PonderSlime/Keyboards/README.md

# Keyboards

A collection of all my personal keyboard projects.
