PonderSlime/Keyboards/keyboards/ergo-kola/README.md

# Ergo-Kola

Planck-inspired ergonomic split keyboard.
Origonally I was going to design a different split keyboard (which i completed), since I thought it would be really cool to have. However, after letting it sit for over a week, I decided that I was not yet statisfied with the final product. Some of these reasons are listed here:
- non-symetric layout
- Neopixels wired incorrectly
- Insane ammout of keys
- Not erginomic or intuitive

By keeping these in mind for my second revision, I was able to complete something that I am much more satisfied with! 

## Bill of Material (without neopixels)
| Part | Qty | Price | Link |
| --- | --- | --- | --- |
| Raspberry Pi Pico | 2 | $10.00 | https://www.digikey.com/en/products/detail/raspberry-pi/SC1631/24627136 |
| PJ-320A TRRS Jack | 2 | $1.00 | https://keeb.io/products/trrs-jack-3-5mm |
| 40cm TRRS Coiled Angled Cable | 1 | $3.99 | https://keeb.io/products/trrs-cable?variant=50550149190 |
| 10uf 0805 Capacitor | 18 | $1.50 | https://www.digikey.com/en/products/detail/murata-electronics/GRM21BR61C106KE15K/2546903 |
| 1N4148W SOD-123 SMD Diode | 52 | $3.85 | https://www.digikey.com/en/products/detail/smc-diode-solutions/1N4148W/6022450 |
| Kailh MX Hotswap Sockets | 52 | $6.60 | https://mechanicalkeyboards.com/products/kailh-switch-hot-swap-socket |
| MX Switches (LED Compatible) | 52 | $20.80 | https://mechanicalkeyboards.com/products/cherry-mx2a-blue-60g-clicky?variant=48020492091692 |
| PCB | 2 | $102.00 | --- | 
| Microcontrollers | 2 | $10.00 | --- |
| Misc Electronics | --- | $12.95 | --- |
| Fasteners | 1 | $3.99 | --- |
| Keys | 52 | $20.80 | --- |
| Keycaps | 52 | $22.00 | --- |
| Shipping | --- | $40.00 | --- |
| Total Price Without Tariffs or shipping | --- | $144.74 | --- |
| Total Price With Tariffs and shipping, since 'merica :c | --- | $211.74 | --- |

## Onshape Link
[https://cad.onshape.com/documents/dbf06a8110e493f29468ba71/w/71af0cc0c8fe44a78097d876/e/75953963970660d857342981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](https://cad.onshape.com/documents/dbf06a8110e493f29468ba71/w/71af0cc0c8fe44a78097d876/e/75953963970660d857342981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)

20250317_10h35m05s_grim
20250317_10h34m52s_grim
20250317_10h34m39s_grim
