PonderSlime/Keyboards/keyboards/split-kola/render/render.png

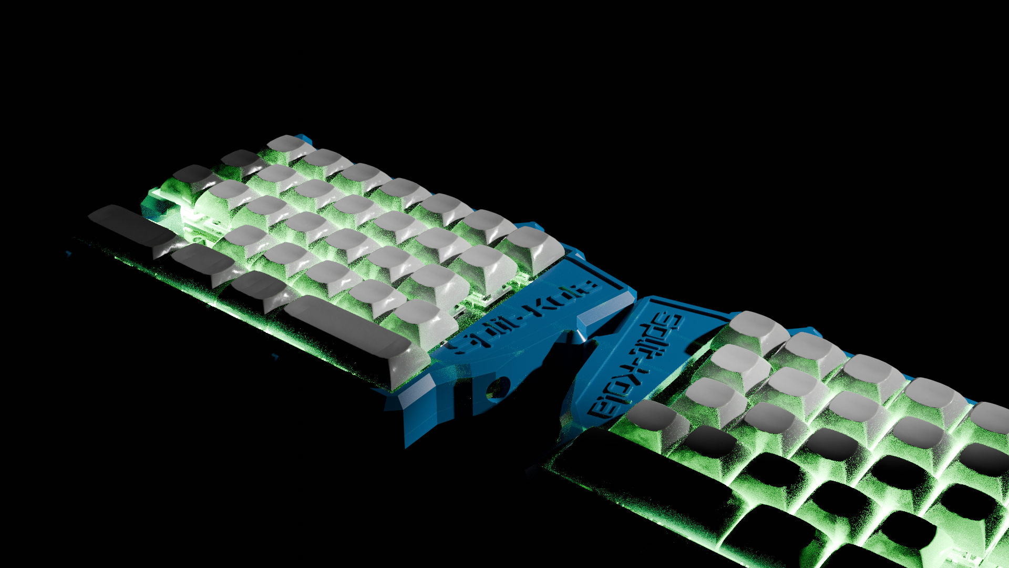
keyboards/split-kola/render/render.png
