PonderSlime/Keyboards/keycaps/QSA/reference/dsa_reference.png

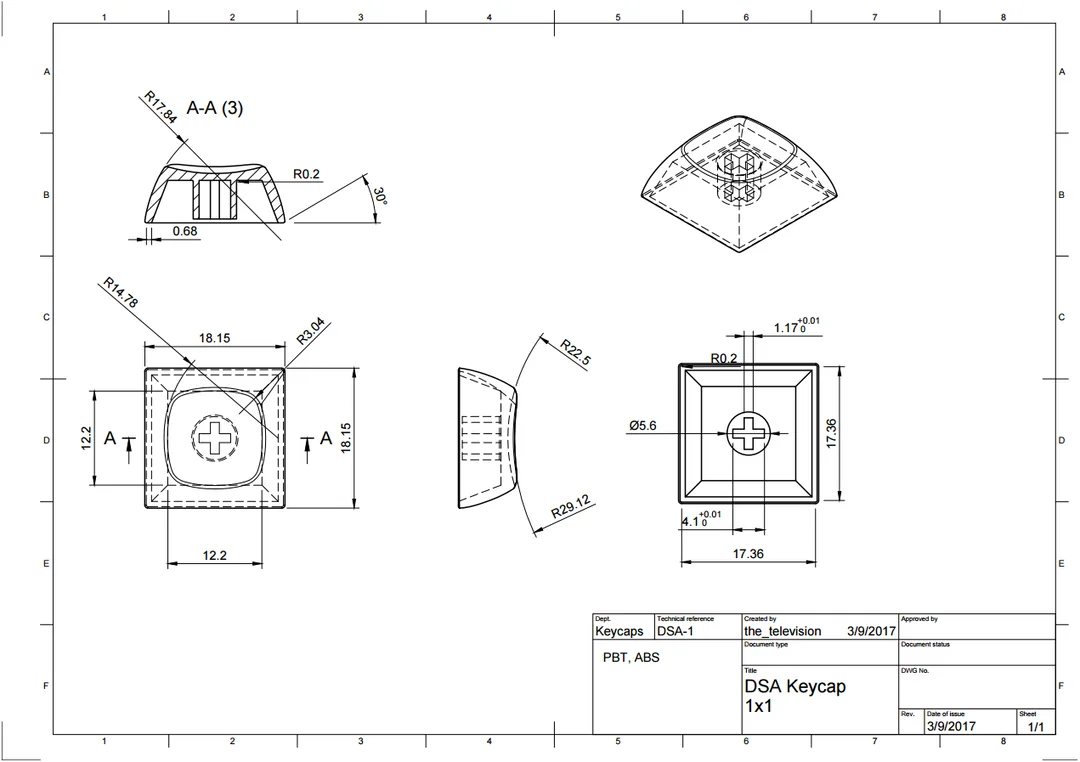
keycaps/QSA/reference/dsa_reference.png
