PonderSlime/Keyboards/keyboards/ergo-kola/cad/export/Ergo-Kola 3D Printed Parts/3D printed parts - Right Case Top.step

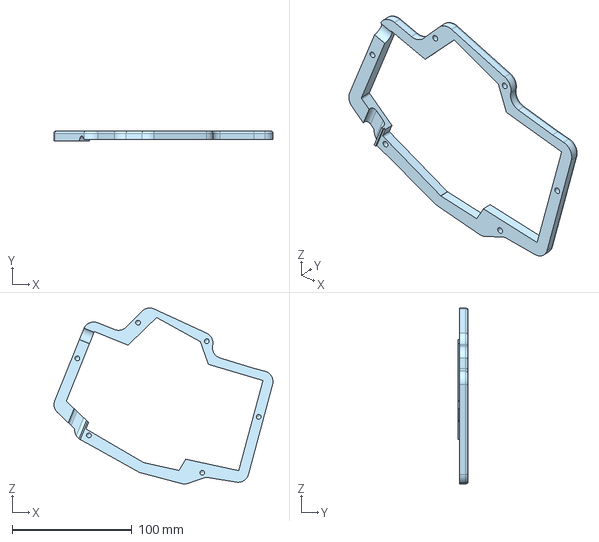
[picture p6: CAD file, 2025-03-15]
keyboards/ergo-kola/cad/export/Ergo-Kola 3D Printed Parts/3D printed parts - Right Case Top.step
183.0 x 8.50 x 147.0 mm
