PonderSlime/Keyboards/keyboards/ergo-kola/cad/reference/plate.dxf

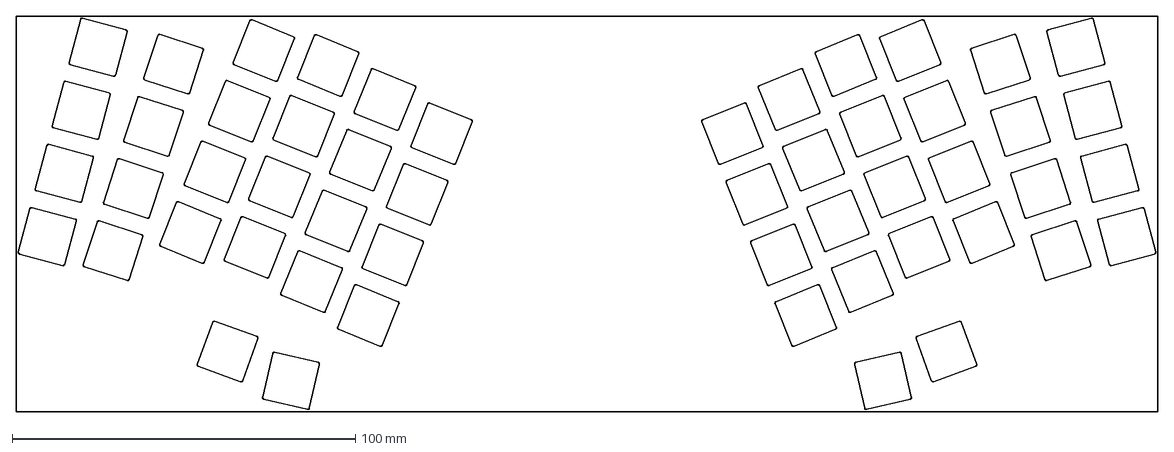
[picture p7: CAD file, 2025-03-15]
keyboards/ergo-kola/cad/reference/plate.dxf
332.6 x 115.3 mm
