PonderSlime/Keyboards/keyboards/ergo-kola/ergogen/output/outlines/right_board_keys_outline.dxf

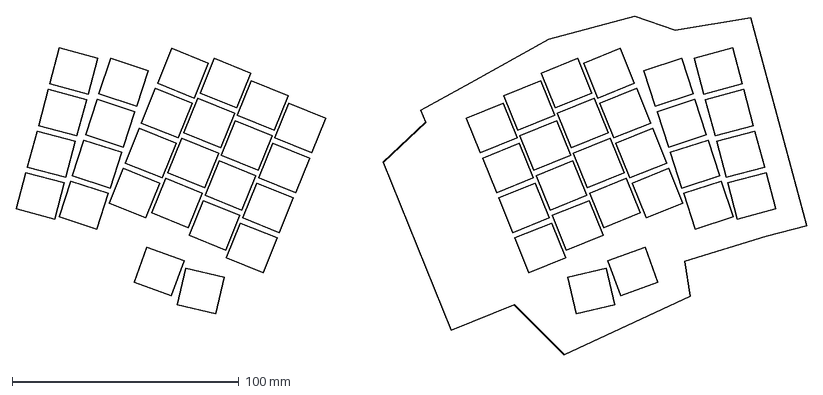
[picture p8: CAD file, 2025-03-15]
keyboards/ergo-kola/ergogen/output/outlines/right_board_keys_outline.dxf
348.5 x 149.2 mm
