PonderSlime/Keyboards/keyboards/split-kola/cad/export/step/3D Printed Parts - Left Plate.step

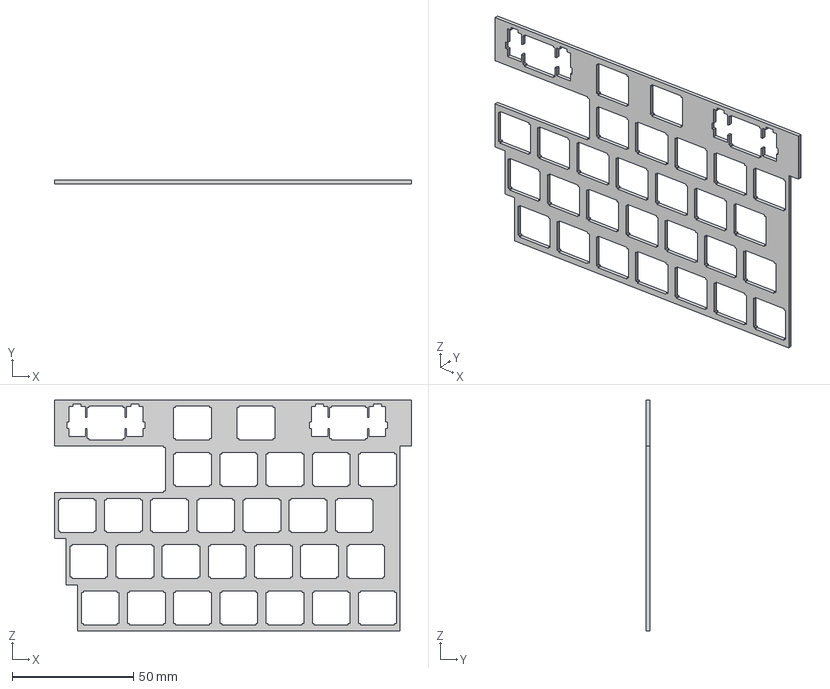
[picture p9: CAD file, 2025-02-25]
keyboards/split-kola/cad/export/step/3D Printed Parts - Left Plate.step
147.2 x 1.50 x 95.3 mm
