PonderSlime/Keyboards/keyboards/split-kola/cad/reference/plate_base.dxf

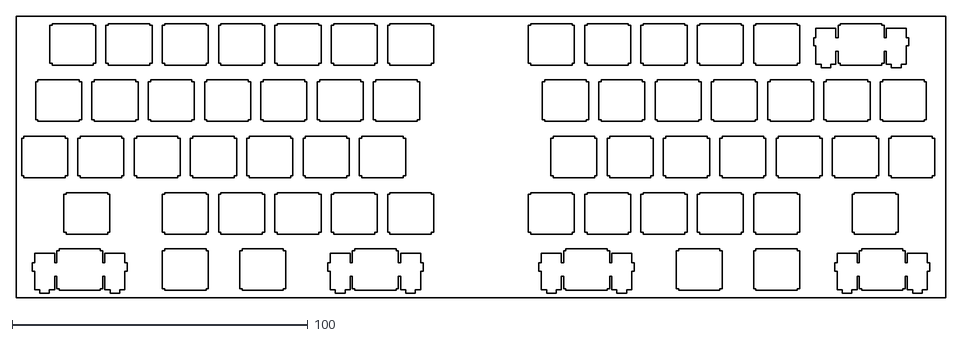
[picture p10: CAD file, 2025-02-24]
keyboards/split-kola/cad/reference/plate_base.dxf
314.3 x 95.2
