PonderSlime/Keyboards/keycaps/QSA/export/QSA V2 - Keycap.step

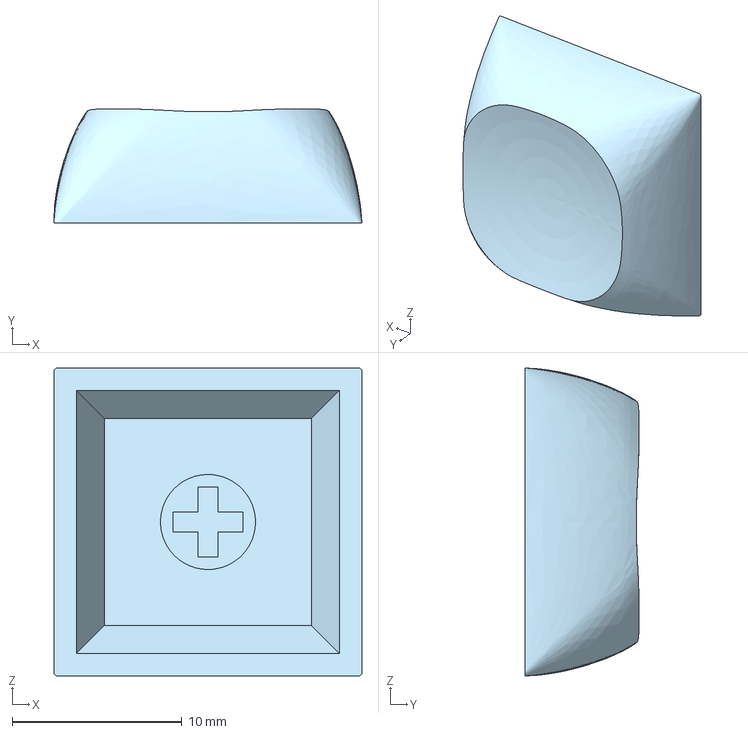
[picture p11: CAD file, 2025-03-17]
keycaps/QSA/export/QSA V2 - Keycap.step
18.1 x 6.74 x 18.1 mm
