PonderSlime/Keyboards/keycaps/QSA/QSA - Keycap x8.3mf

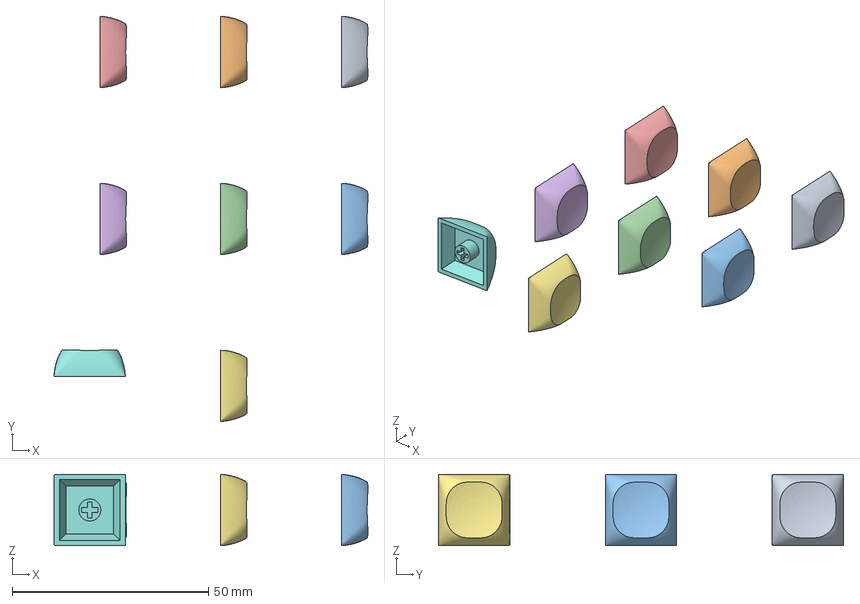
[picture p12: CAD file, 2025-03-17]
keycaps/QSA/QSA - Keycap x8.3mf
79.9 x 103.2 x 18.1 mm
QSA - Keycap.step x 8
