PonderSlime/Keyboards/keyboards/ergo-kola/cad/export/Ergo-Kola 3D Printed Parts/3D printed parts - Right Plate.step

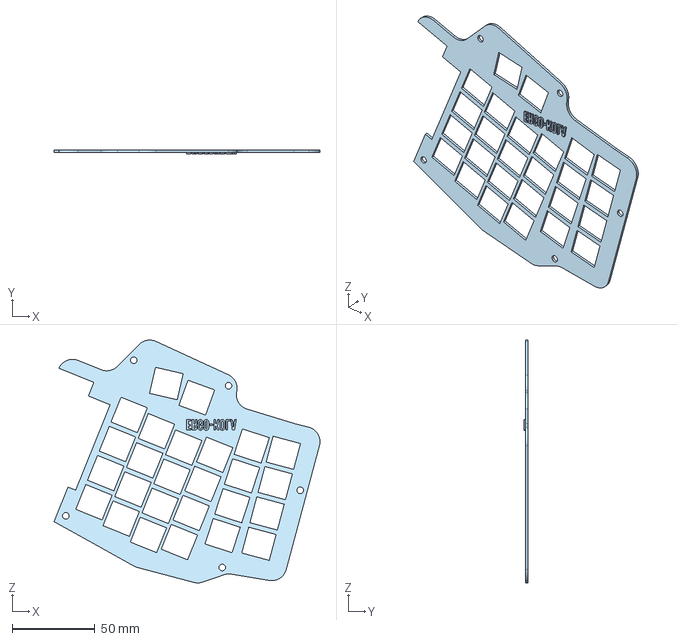
[picture p13: CAD file, 2025-03-15]
keyboards/ergo-kola/cad/export/Ergo-Kola 3D Printed Parts/3D printed parts - Right Plate.step
161.0 x 2.50 x 147.0 mm
