PonderSlime/Keyboards/keyboards/ergo-kola/ergogen/output/outlines/left_board_keys_outline.dxf

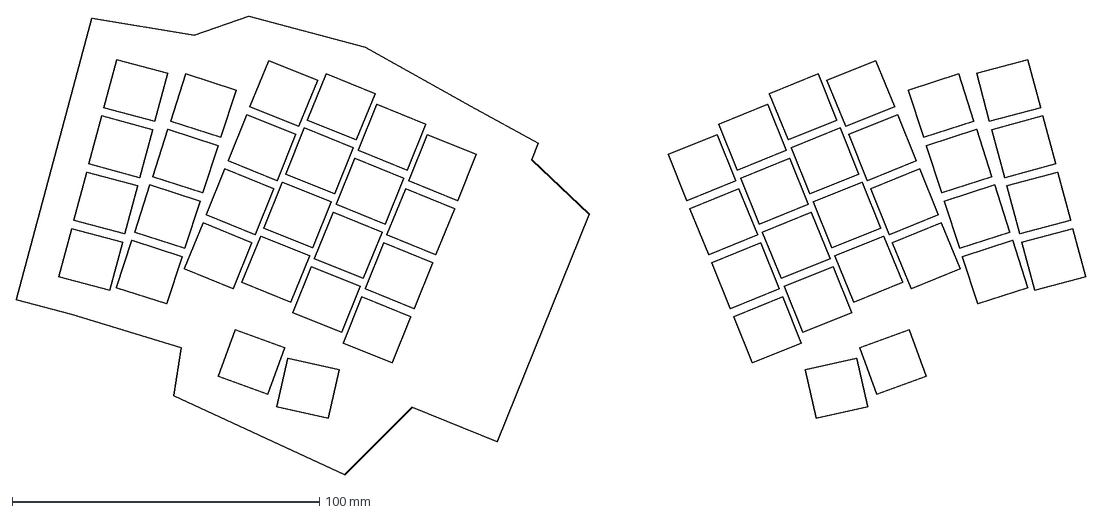
[picture p14: CAD file, 2025-03-15]
keyboards/ergo-kola/ergogen/output/outlines/left_board_keys_outline.dxf
348.4 x 149.2 mm
