PonderSlime/Keyboards/keyboards/split-kola/cad/export/step/3D Printed Parts - Right Top.step

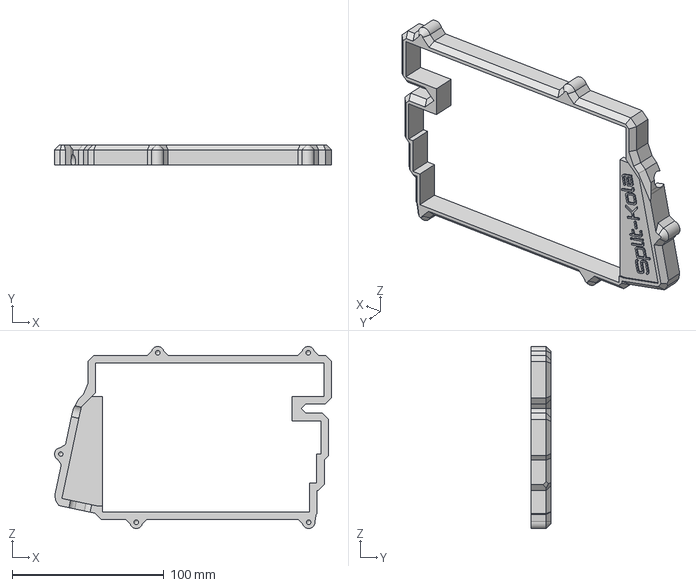
[picture p15: CAD file, 2025-02-25]
keyboards/split-kola/cad/export/step/3D Printed Parts - Right Top.step
182.5 x 12.9 x 120.0 mm
