PonderSlime/Keyboards/keyboards/ergo-kola/cad/export/Ergo-Kola 3D Printed Parts/3D printed parts - Right Case Bottom.step

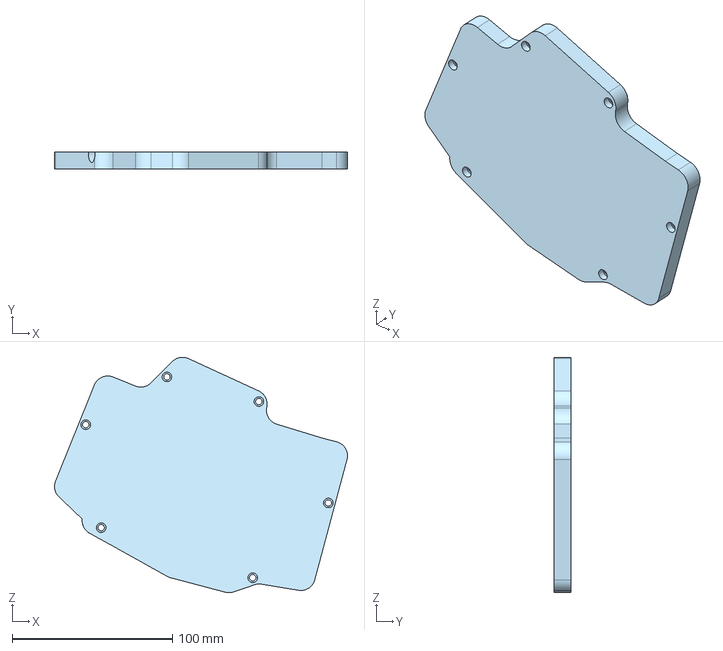
[picture p16: CAD file, 2025-03-15]
keyboards/ergo-kola/cad/export/Ergo-Kola 3D Printed Parts/3D printed parts - Right Case Bottom.step
183.0 x 10.7 x 147.0 mm
