PonderSlime/Keyboards/keyboards/ergo-kola/ergogen/output/outlines/right_board_outline.dxf

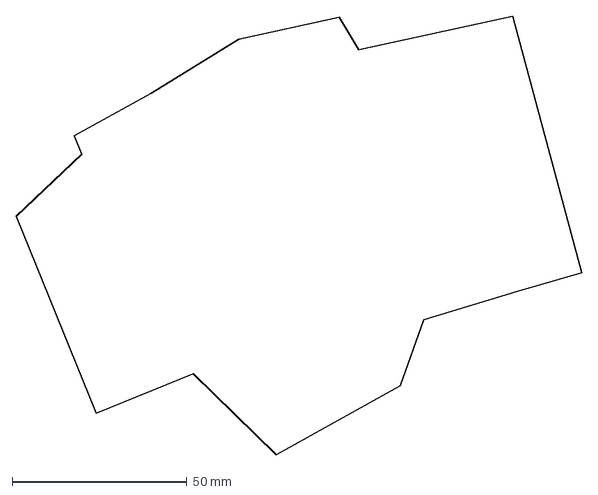
[picture p17: CAD file, 2025-03-15]
keyboards/ergo-kola/ergogen/output/outlines/right_board_outline.dxf
161.7 x 125.4 mm
