PonderSlime/Keyboards/keyboards/ergo-kola/ergogen/output/outlines/keys.dxf

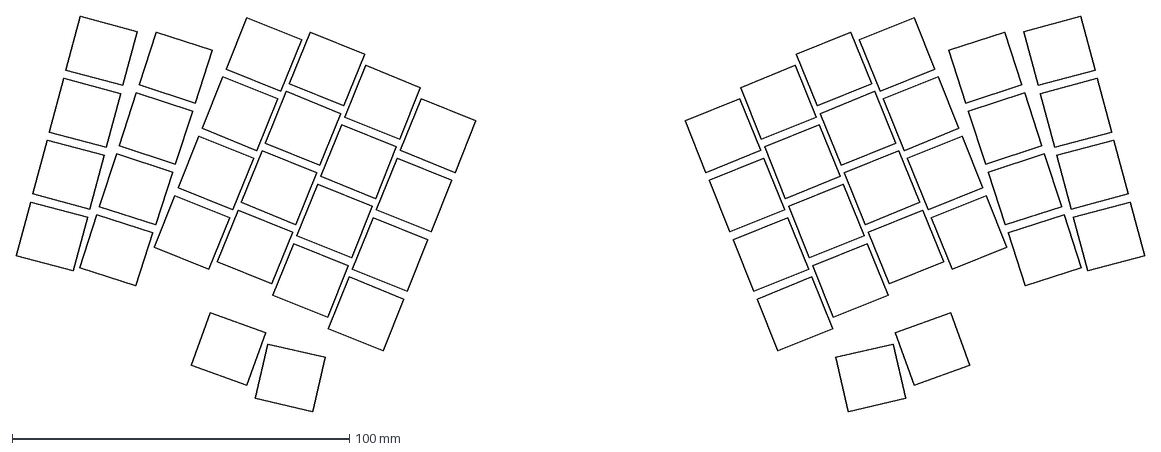
[picture p18: CAD file, 2025-03-15]
keyboards/ergo-kola/ergogen/output/outlines/keys.dxf
334.9 x 117.2 mm
