PonderSlime/Keyboards/keyboards/split-kola/cad/export/step/3D Printed Parts - Right Bottom.step

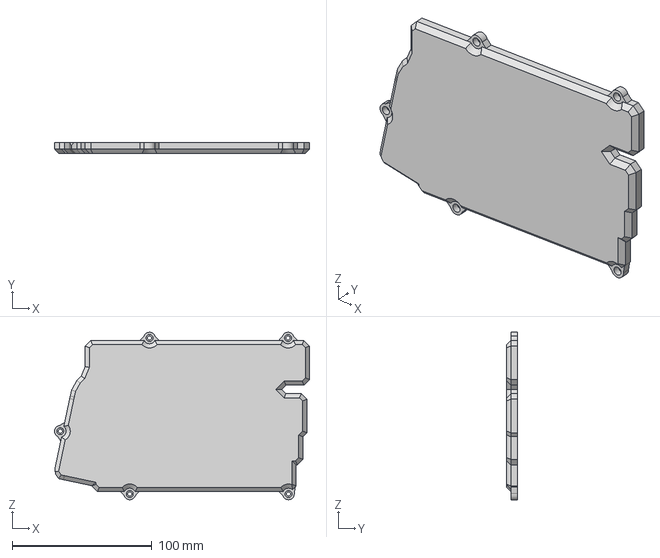
[picture p20: CAD file, 2025-02-25]
keyboards/split-kola/cad/export/step/3D Printed Parts - Right Bottom.step
182.5 x 7.65 x 120.0 mm
