PonderSlime/Keyboards/keyboards/ergo-kola/ergogen/output/outlines/raw.dxf

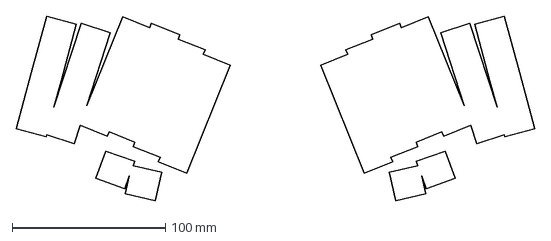
[picture p21: CAD file, 2025-03-15]
keyboards/ergo-kola/ergogen/output/outlines/raw.dxf
337.9 x 120.3 mm
