PonderSlime/Keyboards/keyboards/ergo-kola/ergogen/output/outlines/left_board.dxf

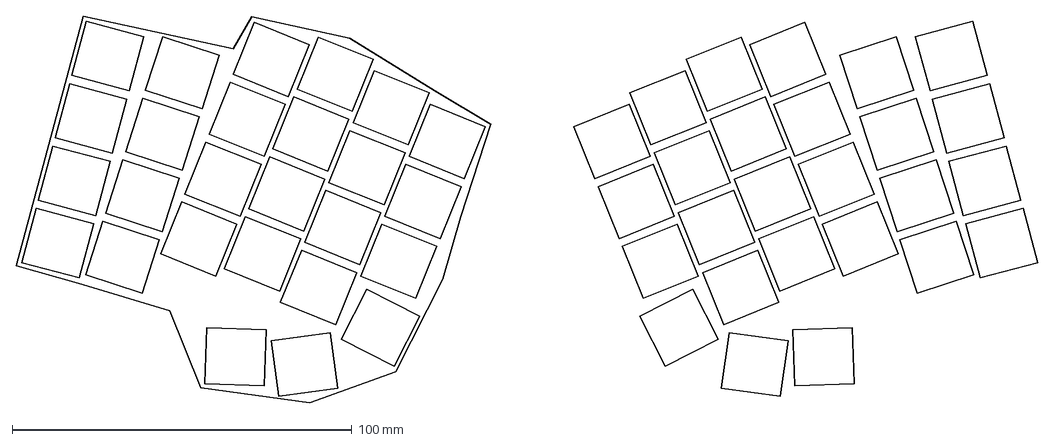
[picture p22: CAD file, 2025-03-13]
keyboards/ergo-kola/ergogen/output/outlines/left_board.dxf
300.4 x 113.8 mm
