PonderSlime/Keyboards/keyboards/ergo-kola/ergogen/output/outlines/right_board.dxf

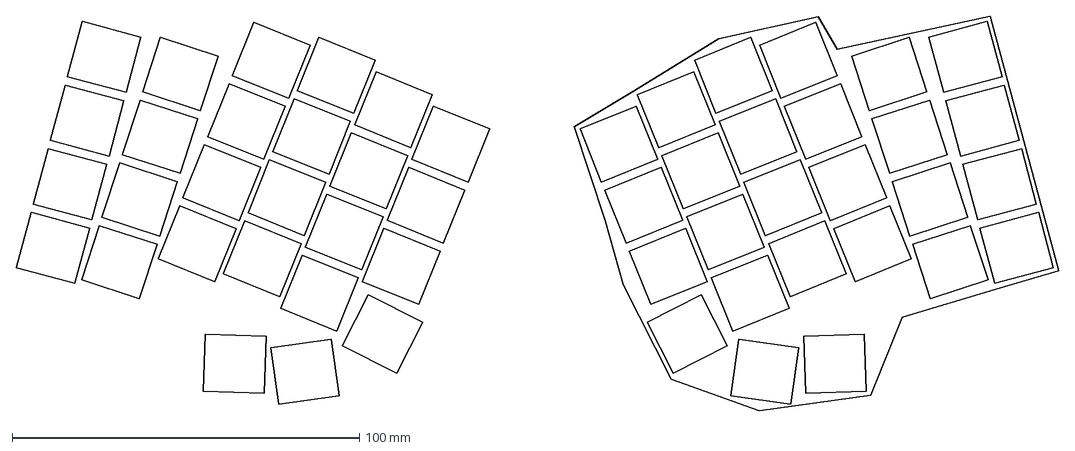
[picture p23: CAD file, 2025-03-13]
keyboards/ergo-kola/ergogen/output/outlines/right_board.dxf
300.4 x 113.8 mm
