PonderSlime/Keyboards/keyboards/ergo-kola/ergogen/output/outlines/box.dxf

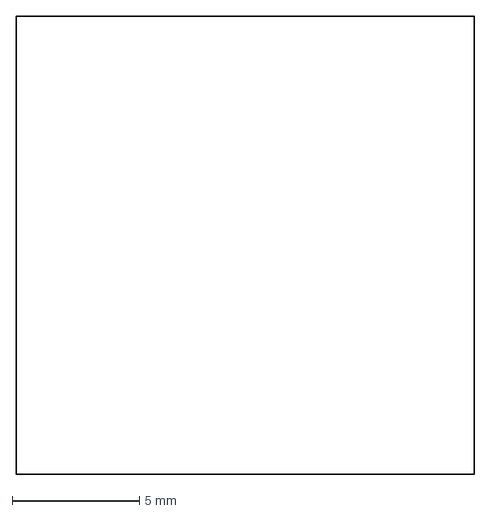
[picture p24: CAD file, 2025-03-13]
keyboards/ergo-kola/ergogen/output/outlines/box.dxf
18.0 x 18.0 mm
