PonderSlime/Keyboards/(list of files, cad)

Other CAD files:
keycaps/QSA/export/QSA - Keycap.step
keyboards/split-kola/cad/export/step/3D Printed Parts - Right Plate.step
keyboards/ergo-kola/cad/export/Ergo-Kola 3D Printed Parts/3D printed parts - Left Plate.step
keyboards/split-kola/cad/export/step/3D Printed Parts - Left Top.step
keyboards/ergo-kola/cad/export/Ergo-Kola 3D Printed Parts/3D printed parts - Left Case Bottom.step
keyboards/ergo-kola/cad/export/Ergo-Kola 3D Printed Parts/3D printed parts - Left Case Top.step
keyboards/split-kola/cad/export/step/3D Printed Parts - Left Bottom.step
keyboards/split-kola/cad/export/stl/3D Printed Parts - Left Bottom.stl
keyboards/split-kola/cad/export/stl/3D Printed Parts - Left Plate.stl
keyboards/split-kola/cad/export/stl/3D Printed Parts - Left Top.stl
keyboards/split-kola/cad/export/stl/3D Printed Parts - Right Bottom.stl
keyboards/split-kola/cad/export/stl/3D Printed Parts - Right Plate.stl
keyboards/split-kola/cad/export/stl/3D Printed Parts - Right Top.stl
