PonderSlime/Keyboards/keyboards/ergo-kola/pcb/ergo-kola/ergo-kola.kicad_pcb

## KiCad design keyboards/ergo-kola/pcb/ergo-kola/ergo-kola.kicad_pcb (2025-09-10)

Schematic: ergo-kola.kicad_sch

Parts:
C1, C2, C3, C4, C5, C6, C7, C8, C9, C10, C11, C12, C13, C14, C15, C16, C17, C18: C 10uf; C_0805_2012Metric_Pad1.18x1.45mm_HandSolder
D1, D2, D3, D4, D5, D6, D7, D8, D9, D10, D11, D12, D13, D14, D15, D16, D17, D18, D19, D20, D21, D22, D23, D24, D25, D26, D27, D28, D29, D30, D31, D32, D33, D34, D35, D36, D37, D38, D39, D40, D41, D42, D43, D44, D45, D46, D47, D48, D49, D50, D51, D52: D; D_SOD-123
J1, J2: L_TRRS; PJ-320A
L1, L2, L3, L4, L5, L6, L7, L8, L9, L10, L11, L12, L13, L14, L15, L16, L17, L18, L19, L20, L21, L22, L23, L24, L25, L26, L27, L28, L29, L30, L31, L32, L33, L34, L35, L36, L37, L38, L39, L40, L41, L42, L43, L44, L45, L46, L47, L48, L49, L50, L51, L52: WS2812B; SK6812-MINI-E
SW1, SW2, SW3, SW4, SW5, SW6, SW7, SW8, SW9, SW10, SW11, SW12, SW13, SW14, SW15, SW16, SW17, SW18, SW19, SW20, SW21, SW22, SW23, SW24, SW25, SW26, SW27, SW28, SW29, SW30, SW31, SW32, SW33, SW34, SW35, SW36, SW37, SW38, SW39, SW40, SW41, SW42, SW43, SW44, SW45, SW46, SW47, SW48, SW49, SW50, SW51, SW52: CherryMX; CherryMX_1.00u_PCB_KailhSocket
U1, U2: Pico; RPi_Pico_SMD_TH

Connections:
GND: C1.1, C2.1, C3.1, C4.1, C5.1, C6.1, C7.1, C8.1, C9.1, C10.1, C11.1, C12.1, C13.1, C14.1, C15.1, C16.1, C17.1, C18.1, J1.1 (S), J2.1 (S), L1.3 (VSS), L2.3 (VSS), L3.3 (VSS), L4.3 (VSS), L5.3 (VSS), L6.3 (VSS), L7.3 (VSS), L8.3 (VSS), L9.3 (VSS), L10.3 (VSS), L11.3 (VSS), L12.3 (VSS), L13.3 (VSS), L14.3 (VSS), L15.3 (VSS), L16.3 (VSS), L17.3 (VSS), L18.3 (VSS), L19.3 (VSS), L20.3 (VSS), L21.3 (VSS), L22.3 (VSS), L23.3 (VSS), L24.3 (VSS), L25.3 (VSS), L26.3 (VSS), L27.3 (VSS), L28.3 (VSS), L29.3 (VSS), L30.3 (VSS), L31.3 (VSS), L32.3 (VSS), L33.3 (VSS), L34.3 (VSS), L35.3 (VSS), L36.3 (VSS), L37.3 (VSS), L38.3 (VSS), L39.3 (VSS), L40.3 (VSS), L41.3 (VSS), L42.3 (VSS), L43.3 (VSS), L44.3 (VSS), L45.3 (VSS), L46.3 (VSS), L47.3 (VSS), L48.3 (VSS), L49.3 (VSS), L50.3 (VSS), L51.3 (VSS), L52.3 (VSS), U1.3 (GND), U1.8 (GND), U1.13 (GND), U1.18 (GND), U1.23 (GND), U1.28 (GND), U1.38 (GND), U1.42 (GND), U2.3 (GND), U2.8 (GND), U2.13 (GND), U2.18 (GND), U2.23 (GND), U2.28 (GND), U2.38 (GND), U2.42 (GND)
L_C0: SW1.1, SW11.1, SW25.1, SW37.1, U1.10 (GPIO7)
L_C1: SW5.1, SW17.1, SW29.1, SW41.1, U1.11 (GPIO8)
L_C2: SW3.1, SW13.1, SW23.1, SW35.1, U1.12 (GPIO9)
L_C3: SW7.1, SW15.1, SW27.1, SW39.1, U1.14 (GPIO10)
L_C4: SW9.1, SW21.1, SW33.1, SW45.1, SW49.1, U1.15 (GPIO11)
L_C5: SW19.1, SW31.1, SW43.1, SW47.1, SW51.1, U1.16 (GPIO12)
L_R0: D1.1 (K), D3.1 (K), D5.1 (K), D7.1 (K), D9.1 (K), D19.1 (K), U1.27 (GPIO21)
L_R1: D11.1 (K), D13.1 (K), D15.1 (K), D17.1 (K), D21.1 (K), D31.1 (K), U1.26 (GPIO20)
L_R2: D23.1 (K), D25.1 (K), D27.1 (K), D29.1 (K), D33.1 (K), D43.1 (K), U1.25 (GPIO19)
L_R3: D35.1 (K), D37.1 (K), D39.1 (K), D41.1 (K), D45.1 (K), D47.1 (K), U1.24 (GPIO18)
L_R4: D49.1 (K), D51.1 (K), U1.22 (GPIO17)
L_RGB: L1.4 (DIN), U1.1 (GPIO0)
L_RX: J1.3 (R1), U1.7 (GPIO5_(RX))
L_TX: J1.4 (R2), U1.6 (GPIO4_(TX))
L_VBUS: C1.2, C2.2, C3.2, C4.2, C5.2, C6.2, C7.2, C8.2, C9.2, J1.2 (T), L1.1 (VDD), L3.1 (VDD), L5.1 (VDD), L7.1 (VDD), L9.1 (VDD), L11.1 (VDD), L13.1 (VDD), L15.1 (VDD), L17.1 (VDD), L19.1 (VDD), L21.1 (VDD), L23.1 (VDD), L25.1 (VDD), L27.1 (VDD), L29.1 (VDD), L31.1 (VDD), L33.1 (VDD), L35.1 (VDD), L37.1 (VDD), L39.1 (VDD), L41.1 (VDD), L43.1 (VDD), L45.1 (VDD), L47.1 (VDD), L49.1 (VDD), L51.1 (VDD), U1.40 (VBUS)
unnamed: D1.2 (A), SW1.2
unnamed: D2.2 (A), SW2.2
unnamed: D3.2 (A), SW3.2
unnamed: D4.2 (A), SW4.2
unnamed: D5.2 (A), SW5.2
unnamed: D6.2 (A), SW6.2
unnamed: D7.2 (A), SW7.2
unnamed: D8.2 (A), SW8.2
unnamed: D9.2 (A), SW9.2
unnamed: D10.2 (A), SW10.2
unnamed: D11.2 (A), SW11.2
unnamed: D12.2 (A), SW12.2
unnamed: D13.2 (A), SW13.2
unnamed: D14.2 (A), SW14.2
unnamed: D15.2 (A), SW15.2
unnamed: D16.2 (A), SW16.2
unnamed: D17.2 (A), SW17.2
unnamed: D18.2 (A), SW18.2
unnamed: D19.2 (A), SW19.2
unnamed: D20.2 (A), SW20.2
unnamed: D21.2 (A), SW21.2
unnamed: D22.2 (A), SW22.2
unnamed: D23.2 (A), SW23.2
unnamed: D24.2 (A), SW24.2
unnamed: D25.2 (A), SW25.2
unnamed: D26.2 (A), SW26.2
unnamed: D27.2 (A), SW27.2
unnamed: D28.2 (A), SW28.2
unnamed: D29.2 (A), SW29.2
unnamed: D30.2 (A), SW30.2
unnamed: D31.2 (A), SW31.2
unnamed: D32.2 (A), SW32.2
unnamed: D33.2 (A), SW33.2
unnamed: D34.2 (A), SW34.2
unnamed: D35.2 (A), SW35.2
unnamed: D36.2 (A), SW36.2
unnamed: D37.2 (A), SW37.2
unnamed: D38.2 (A), SW38.2
unnamed: D39.2 (A), SW39.2
unnamed: D40.2 (A), SW40.2
unnamed: D41.2 (A), SW41.2
unnamed: D42.2 (A), SW42.2
unnamed: D43.2 (A), SW43.2
unnamed: D44.2 (A), SW44.2
unnamed: D45.2 (A), SW45.2
unnamed: D46.2 (A), SW46.2
unnamed: D47.2 (A), SW47.2
unnamed: D48.2 (A), SW48.2
unnamed: D49.2 (A), SW49.2
unnamed: D50.2 (A), SW50.2
unnamed: D51.2 (A), SW51.2
unnamed: D52.2 (A), SW52.2
unnamed: L1.2 (DOUT), L5.4 (DIN)
unnamed: L2.4 (DIN), L6.2 (DOUT)
unnamed: L2.2 (DOUT), L32.4 (DIN)
unnamed: L3.4 (DIN), L5.2 (DOUT)
unnamed: L3.2 (DOUT), L7.4 (DIN)
unnamed: L4.4 (DIN), L8.2 (DOUT)
unnamed: L4.2 (DOUT), L6.4 (DIN)
unnamed: L7.2 (DOUT), L9.4 (DIN)
unnamed: L10.4 (DIN), L20.2 (DOUT)
unnamed: L8.4 (DIN), L10.2 (DOUT)
unnamed: L11.4 (DIN), L19.2 (DOUT)
unnamed: L11.2 (DOUT), L17.4 (DIN)
unnamed: L12.4 (DIN), L18.2 (DOUT)
unnamed: L12.2 (DOUT), L44.4 (DIN)
unnamed: L13.4 (DIN), L17.2 (DOUT)
unnamed: L13.2 (DOUT), L15.4 (DIN)
unnamed: L14.4 (DIN), L16.2 (DOUT)
unnamed: L14.2 (DOUT), L18.4 (DIN)
unnamed: L15.2 (DOUT), L21.4 (DIN)
unnamed: L16.4 (DIN), L22.2 (DOUT)
unnamed: L9.2 (DOUT), L19.4 (DIN)
unnamed: L21.2 (DOUT), L31.4 (DIN)
unnamed: L22.4 (DIN), L32.2 (DOUT)
unnamed: L23.4 (DIN), L29.2 (DOUT)
unnamed: L23.2 (DOUT), L27.4 (DIN)
unnamed: L24.4 (DIN), L28.2 (DOUT)
unnamed: L24.2 (DOUT), L30.4 (DIN)
unnamed: L25.4 (DIN), L31.2 (DOUT)
unnamed: L25.2 (DOUT), L29.4 (DIN)
unnamed: L26.4 (DIN), L30.2 (DOUT)
unnamed: L26.2 (DOUT), L48.4 (DIN)
unnamed: L27.2 (DOUT), L33.4 (DIN)
unnamed: L28.4 (DIN), L34.2 (DOUT)
unnamed: L33.2 (DOUT), L43.4 (DIN)
unnamed: L34.4 (DIN), L44.2 (DOUT)
unnamed: L35.4 (DIN), L41.2 (DOUT)
unnamed: L35.2 (DOUT), L39.4 (DIN)
unnamed: L36.4 (DIN), L40.2 (DOUT)
unnamed: L36.2 (DOUT), L42.4 (DIN)
unnamed: L37.4 (DIN), L43.2 (DOUT)
unnamed: L37.2 (DOUT), L41.4 (DIN)
unnamed: L38.4 (DIN), L42.2 (DOUT)
unnamed: L38.2 (DOUT), L52.4 (DIN)
unnamed: L39.2 (DOUT), L45.4 (DIN)
unnamed: L40.4 (DIN), L46.2 (DOUT)
unnamed: L45.2 (DOUT), L47.4 (DIN)
unnamed: L46.4 (DIN), L48.2 (DOUT)
unnamed: L47.2 (DOUT), L49.4 (DIN)
unnamed: L49.2 (DOUT), L51.4 (DIN)
unnamed: L50.4 (DIN), L52.2 (DOUT)
R_C6: SW20.1, SW32.1, SW44.1, SW48.1, SW52.1, U2.9 (GPIO6)
R_C7: SW10.1, SW22.1, SW34.1, SW46.1, SW50.1, U2.10 (GPIO7)
R_C8: SW8.1, SW16.1, SW28.1, SW40.1, U2.11 (GPIO8)
R_C9: SW4.1, SW14.1, SW24.1, SW36.1, U2.12 (GPIO9)
R_C10: SW6.1, SW18.1, SW30.1, SW42.1, U2.14 (GPIO10)
R_C11: SW2.1, SW12.1, SW26.1, SW38.1, U2.15 (GPIO11)
R_R0: D2.1 (K), D4.1 (K), D6.1 (K), D8.1 (K), D10.1 (K), D20.1 (K), U2.27 (GPIO21)
R_R1: D12.1 (K), D14.1 (K), D16.1 (K), D18.1 (K), D22.1 (K), D32.1 (K), U2.26 (GPIO20)
R_R2: D24.1 (K), D26.1 (K), D28.1 (K), D30.1 (K), D34.1 (K), D44.1 (K), U2.25 (GPIO19)
R_R3: D36.1 (K), D38.1 (K), D40.1 (K), D42.1 (K), D46.1 (K), D48.1 (K), U2.24 (GPIO18)
R_R4: D50.1 (K), D52.1 (K), U2.22 (GPIO17)
R_RGB: L20.4 (DIN), U2.1 (GPIO0)
R_RX: J2.4 (R2), U2.7 (GPIO5_(RX))
R_TX: J2.3 (R1), U2.6 (GPIO4_(TX))
R_VBUS: C10.2, C11.2, C12.2, C13.2, C14.2, C15.2, C16.2, C17.2, C18.2, J2.2 (T), L2.1 (VDD), L4.1 (VDD), L6.1 (VDD), L8.1 (VDD), L10.1 (VDD), L12.1 (VDD), L14.1 (VDD), L16.1 (VDD), L18.1 (VDD), L20.1 (VDD), L22.1 (VDD), L24.1 (VDD), L26.1 (VDD), L28.1 (VDD), L30.1 (VDD), L32.1 (VDD), L34.1 (VDD), L36.1 (VDD), L38.1 (VDD), L40.1 (VDD), L42.1 (VDD), L44.1 (VDD), L46.1 (VDD), L48.1 (VDD), L50.1 (VDD), L52.1 (VDD), U2.40 (VBUS)

Notes on the sheet:
TRRS Cable
Encoder
MX Switch Matrix
Per-Key RGB Lighting
Use PJ-320A TRRS Jack for this
Use an EC12 Encoder, with a varying height for the cap to get it to the preferred height
Use SK6812MINI-E LEDs or similar for this
use these 10 uf capacitors:
Use standard Kailh Hotswap Sockets (And Cherry MX Reds) Probably use Durock stabalizers for this too Also, 1N4148W Diodes
https://www.digikey.com/en/products/detail/murata-electronics/GRM21BR61C106KE15K/2546903

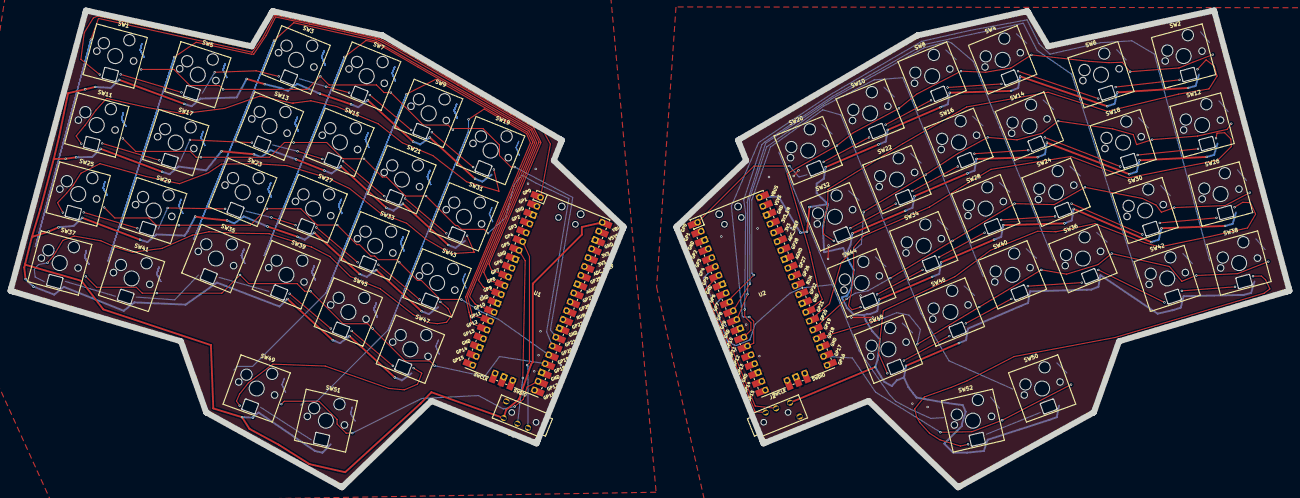
[picture p25: board ergo-kola.kicad_pcb from above]

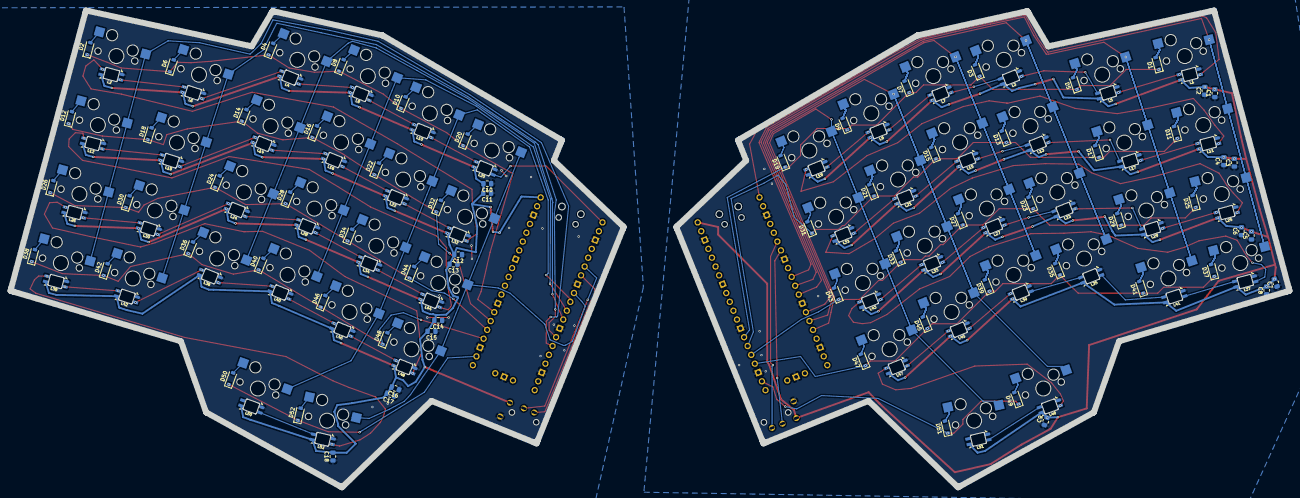
[picture p26: board ergo-kola.kicad_pcb from below]

Board: 2 copper layers, 341.1 x 127.2 mm, 178 parts (122 on the bottom side), 133 nets.
