PonderSlime/Keyboards/(commit log)

2025-02-22 Pcb half done!
    [splitbk.kicad_pcb, splitbk.kicad_sch]
2025-02-22 All rows wired, Moving onto rightside LED placement
    [splitbk.kicad_pcb, splitbk.kicad_sch]
2025-02-22 PCB Routing Completed
    [splitbk.kicad_pcb, splitbk.kicad_sch]
2025-02-23 Rebranded the keyboard! :)
    [splitbk.kicad_pcb, splitbk.kicad_sch]
2025-02-23 Finished rebranding, added 3d model!
    [split-kola.kicad_pcb, split-kola.kicad_sch, splitbk.kicad_pcb, splitbk.kicad_sch]
2025-02-24 Added the firmware, added base plate file template + Reference model
    [plate_base.dxf]
2025-02-25 Added the case files, Compiled firmware, Hopefully works
    [3D Printed Parts - Left Bottom.step, 3D Printed Parts - Left Bottom.stl, 3D Printed Parts - Left Plate.step, 3D Printed Parts - Left Plate.stl, 3D Printed Parts - Left Top.step, 3D Printed Parts - Left Top.stl, 3D Printed Parts - Right Bottom.step, 3D Printed Parts - Right Bottom.stl]
2025-02-25 Added branding to the case, and added pictures
    [3D Printed Parts - Left Bottom.step, 3D Printed Parts - Left Bottom.stl, 3D Printed Parts - Left Plate.step, 3D Printed Parts - Left Top.step, 3D Printed Parts - Left Top.stl, 3D Printed Parts - Right Bottom.step, 3D Printed Parts - Right Bottom.stl, 3D Printed Parts - Right Plate.step]
2025-02-25 Added branding to pcb
    [split-kola.kicad_pcb]
2025-03-13 Started Ergo-Kola Keyboard
    [bad_template.kicad_pcb, box.dxf, ergo-kola.kicad_pcb, ergo-kola.kicad_sch, keys.dxf, left_board.dxf, left_board_keys_outline.dxf, left_board_outline.dxf]
2025-03-13 Autolayout did not work (experiment), manually doing it via spreadsheet
    [bad_template.kicad_pcb, ergo-kola.kicad_pcb, ergo-kola.kicad_sch, keys.dxf, left_board_keys_outline.dxf, left_board_outline.dxf, raw.dxf, right_board_keys_outline.dxf]
2025-03-15 PCB Done!
    [ergo-kola.kicad_sch, keys.dxf, left_board_keys_outline.dxf, left_board_outline.dxf, raw.dxf, right_board_keys_outline.dxf, right_board_outline.dxf]
2025-03-15 Finished PCB and Case!
    [3D printed parts - Left Case Bottom.step, 3D printed parts - Left Case Top.step, 3D printed parts - Left Plate.step, 3D printed parts - Right Case Bottom.step, 3D printed parts - Right Case Top.step, 3D printed parts - Right Plate.step, ergo-kola.kicad_pcb, left_board_keys_outline.dxf]
2025-03-15 Fixed an oopsie mistake
    [3D printed parts - Left Case Bottom.step, 3D printed parts - Left Case Top.step, 3D printed parts - Left Plate.step, 3D printed parts - Right Case Bottom.step, 3D printed parts - Right Case Top.step, 3D printed parts - Right Plate.step]
2025-03-16 Neopixels power fixed
    [ergo-kola.kicad_pcb, ergo-kola.kicad_sch]
2025-03-17 Moved folders of stuff
    [3D Printed Parts - Left Bottom.step, 3D Printed Parts - Left Bottom.stl, 3D Printed Parts - Left Plate.step, 3D Printed Parts - Left Plate.stl, 3D Printed Parts - Left Top.step, 3D Printed Parts - Left Top.stl, 3D Printed Parts - Right Bottom.step, 3D Printed Parts - Right Bottom.stl]
2025-03-17 Added bill of materials for ergo-kola
2025-03-17 Organized BOM
2025-06-06 Added Ergo-Kola BOM
    [BOM.csv]
2025-09-10 Added ergo-kola output, retro-70-kb git submodule added
    [ergo-kola-B_Cu.gbr, ergo-kola-B_Mask.gbr, ergo-kola-B_Paste.gbr, ergo-kola-B_Silkscreen.gbr, ergo-kola-Edge_Cuts.gbr, ergo-kola-F_Cu.gbr, ergo-kola-F_Mask.gbr, ergo-kola-F_Paste.gbr]
2025-10-06 Update README.md
    Added TRRS Cable to BOM
2025-10-06 Update BOM.csv
    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
    [BOM.csv]
2025-10-06 Fixed issues with URLs
    [BOM.csv]
2025-10-06 Update README.md
    Fixed BOM URLs again
2025-10-06 Update README.md
    Fully fixed MarkDown BOM
2025-10-06 Update BOM.csv
    Added pricing to BOM.csv
    [BOM.csv]
2025-10-06 Update README.md
    Added total price to BOM
2025-10-06 Update README.md
    Removed SplitKB from the ordering stuff to cut costs on shipping
2025-10-06 Update BOM.csv
    Removed SplitKB.com from the BOM
    [BOM.csv]
2025-10-09 Update README.md
    Added keycaps to price, fixed other issues with costs in BOM (now $145 dollars :/ )
2025-10-09 Update BOM.csv
    Syncronized with BOM in README.md
    [BOM.csv]
2025-10-09 Split board files in two, exported both sides for production
    [ergo-kola (another copy)-B_Cu.gbr, ergo-kola (another copy)-B_Mask.gbr, ergo-kola (another copy)-B_Paste.gbr, ergo-kola (another copy)-B_Silkscreen.gbr, ergo-kola (another copy)-Edge_Cuts.gbr, ergo-kola (another copy)-F_Cu.gbr, ergo-kola (another copy)-F_Mask.gbr, ergo-kola (another copy)-F_Paste.gbr]
2025-10-11 Update BOM.csv
    Added tariffs ('merica >:c )
    [BOM.csv]
